zetasyanthis/quadruped/README.md

An old student project of mine!

v1 (SNUT) and v2 (ECE597) included!
