zetasyanthis/quadruped/ECE597_Robot_v2/quadruplex/trunk/doc/presentations/media/robot_v1.jpg

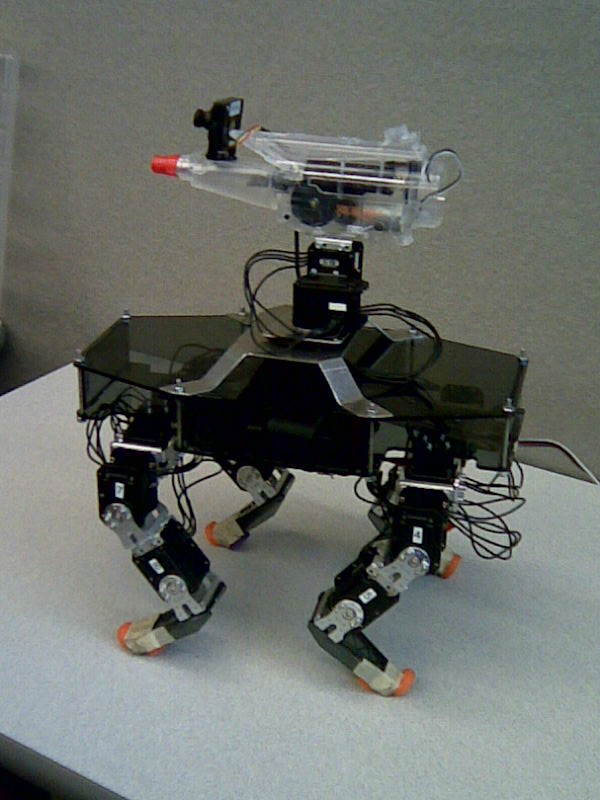
ECE597_Robot_v2/quadruplex/trunk/doc/presentations/media/robot_v1.jpg
