zetasyanthis/quadruped/ECE597_Robot_v2/quadruplex/trunk/doc/presentations/media/tasks.png

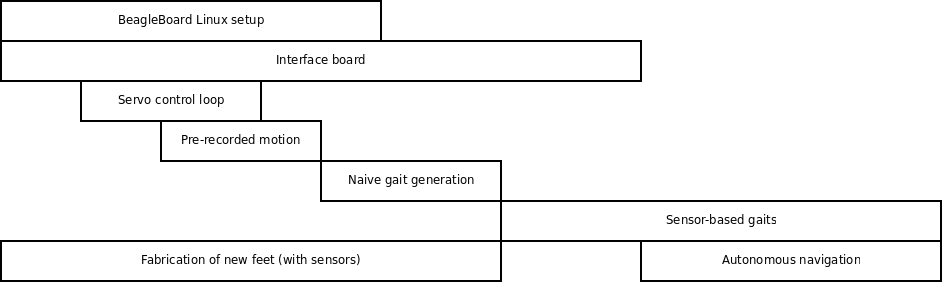
ECE597_Robot_v2/quadruplex/trunk/doc/presentations/media/tasks.png
