zetasyanthis/quadruped/ECE597_Robot_v2/quadruplex/trunk/doc/report/figures/cimg7274-board-unpopulated.jpg

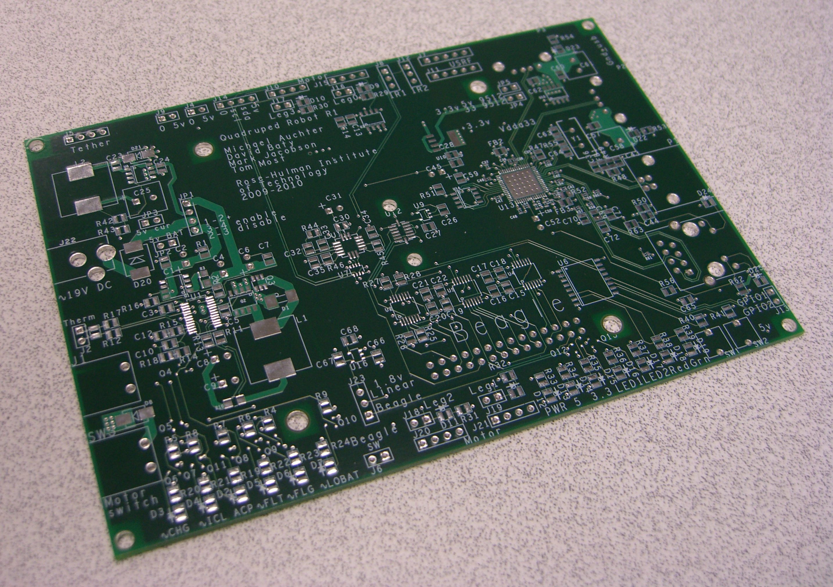
ECE597_Robot_v2/quadruplex/trunk/doc/report/figures/cimg7274-board-unpopulated.jpg
