zetasyanthis/quadruped/ECE597_Robot_v2/quadruplex/trunk/doc/software/figures/leg.jpg

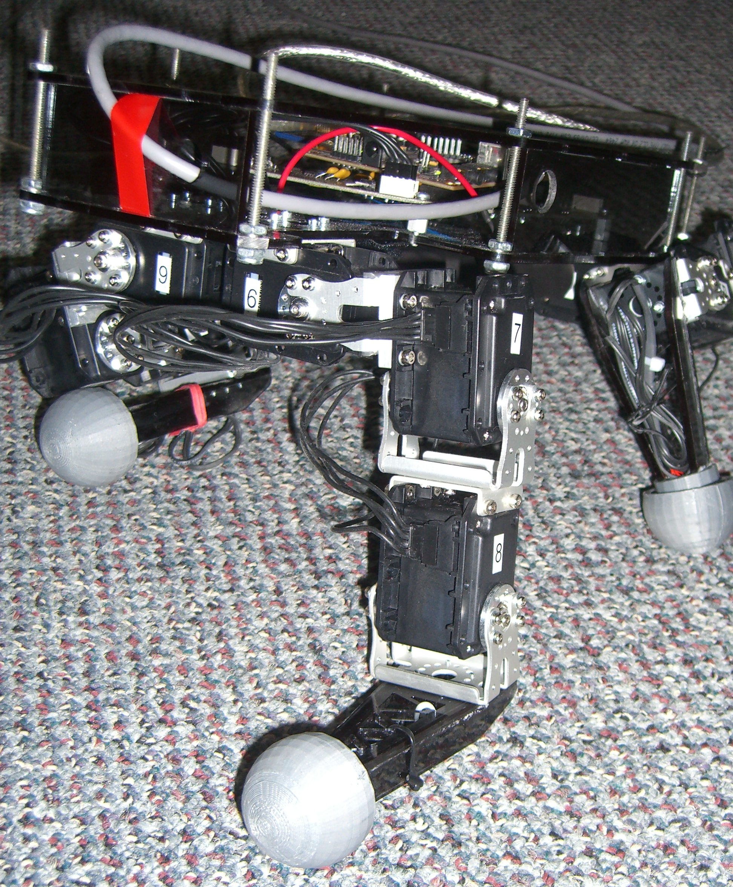
ECE597_Robot_v2/quadruplex/trunk/doc/software/figures/leg.jpg
