zetasyanthis/quadruped/ECE597_Robot_v2/quadruplex/trunk/pcb/BOM.xls

Quantity | Reference | Footprint | Value | Description | DigiKey | Mouser | Manufacturer | Man. Part Num | Min Quant | Unit Price | Total
29 | C1,C3,C13,C15,C17,C19,C21,C30,C29,C37,C38,C39,C40,C41,C42,C43,C44,C46,C47,C48,C49,C50,C51,C53,C54,C55,C57,C59,C60 | 0805 | 0.1uF | CAP CERM .10UF 50V 20% 0805 SMD | 478-3351-1-ND |  | AVX Corporation | 08055C104MAT2A | 10 | $0.05 | $1.33
2 | C11, C33 | 0805 | 0.47uF | CAP CERAMIC .47UF 25V X7R 0805 | 311-1364-1-ND |  | Yageo | CC0805KKX7R8BB474 | 10 | $0.09 | $0.91
1 | C12 | 0805 | 0.12uF | CAP .12UF 16V CERAMIC X7R 0805 | PCC1813CT-ND |  | Panasonic ECG | ECJ-2VB1C124K | 1 | $0.55 | $0.55
16 | C14,C16,C18,C20,C22,C24,C26,C27,C34,C35,C28,C36,C56,C62,C66,C67 | 0805 | 1uF | CAP CER 1.0UF 50V Y5V 0805 | 587-1308-1-ND |  | Taiyo Yuden | UMK212F105ZG-T | 10 | $0.09 | $1.41
6 | C2,C4,C6,C8,C9,C31 |  | 10uF | CAP ELECT 10UF 35V KS RADIAL | P980-ND |  | Panasonic ECG | ECE-A1VKS100 | 1 | $0.08 | $0.50
3 | C23,C32,C68 | 0805 | 0.01uF | CAP 10000PF 50V CERAMIC X7R 0805 | 399-1158-1-ND |  | Kemet | C0805C103K5RACTU | 10 | $0.03 | $0.31
1 | C25 |  | 470uF | CAP 470UF 16V ALUM LYTIC RADIAL | P5141-ND |  | Panasonic ECG | ECA-1CM471 | 1 | $0.26 | $0.26
2 | C45,C52 |  | 4.7uF | CAP 4.7UF 50V ELECT EB RADIAL | P13465-ND |  | Panasonic ECG | EEU-EB1H4R7S | 1 | $0.11 | $0.22
1 | C5 | 0805 | 15nF | CAP 15000PF 50V CERAMIC X7R 0805 | 399-1161-1-ND |  | Kemet | C0805C153K5RACTU | 10 | $0.05 | $0.46
2 | C58,C61 |  | 150uF | CAP 150UF 35V ELECT FM RADIAL | P12408-ND |  | Panasonic ECG | EEU-FM1V151 | 1 | $0.32 | $0.64
2 | C63,C64 | 0805 | 33pF | CAP CERAMIC 33PF 50V NP0 0805 | 399-1115-1-ND |  | Kemet | C0805C330J5GACTU | 10 | $0.05 | $0.48
1 | C65 | 0805 | 0.022uF | CAP 22000PF 50V CERAMIC X7R 0805 | 399-1163-1-ND |  | Kemet | C0805C223K5RACTU | 10 | $0.06 | $0.58
2 | C7,C10 | 0805 | 0.0047uF | CAP 4700PF 50V CERAMIC X7R 0805 | 399-1155-1-ND |  | Kemet | C0805C472K5RACTU | 10 | $0.04 | $0.43
1 | D1 |  |  | DIODE SCHOTTKY 40V 1A SMB | MBRS140T3GOSCT-ND |  | ON Semiconductor | MBRS140T3G | 1 | $0.41 | $0.41
6 | D2,D22,D23,D17,D19,D25 | 0805p | Green | LED GREEN CLEAR 0805 SMD | 160-1179-1-ND |  | Lite-On Inc | LTST-C170GKT | 1 | $0.09 | $0.54
1 | D20 |  | Reverse | DIODE SCHOTTKY 4A 30V SMC | SL43-E3/57TGICT-ND |  | Vishay | SL43-E3/57T | 1 | $1.07 | $1.07
1 | D21 |  |  | DIODE SCHOTTKY 40V 2A SMA | B240A-FDICT-ND |  | Diodes Inc | B240A-13-F | 1 | $0.42 | $0.42
4 | D3,D4,D7,D24 | 0805p | Amber | LED AMBER CLEAR 0805 SMD | 160-1177-1-ND |  | Lite-On Inc | LTST-C170AKT | 1 | $0.11 | $0.44
11 | D5,D6,D9,D10,D11,D12,D13,D14,D15,D16,D18 | 0805p | Red | LED RED CLEAR 0805 SMD | 160-1176-1-ND |  | Lite-On Inc | LTST-C170CKT | 1 | $0.09 | $1.02
1 | D8 |  |  | DIODE SCHOTTKY 60V 3A SMA | B360A-FDICT-ND |  | Diodes Inc | B360A-13-F | 1 | $0.56 | $0.56
1 | External |  |  | THERMISTOR 10K OHM 30MM L NTC | 490-4653-ND |  | Murata Electronics | NTSD1XH103FPB30 | 1 | $0.56 | $0.56
1 | External |  |  | CONN 2.1MM FEMALE PLUG 5.5MM OUT | CP3-1000-ND |  | CUI Inc | PP3-002A | 1 | $0.93 | $0.93
20 | External |  |  | CONN TERM FEMALE 22-30AWG TIN | WM1114-ND |  | Molex | 08-50-0114 | 100 | $0.04 | $3.90
3 | FB1,FB2,FB3 |  |  | FERRITE BEAD 120 OHM 0805 | 587-1747-1-ND |  | Taiyo Yuden | FBMH2012HM121-T | 10 | $0.09 | $0.94
2 | J1,SW3 |  | Battery | CONN HEADER RT ANG 2POS 5.08MM | 277-1106-ND |  | Phoenix Contacts | 1757242 | 1 | $0.46 | $0.92
4 | J11,J13,External |  | USRF | CONN HEADER 5POS .100 VERT TIN | WM4203-ND |  | Molex Inc | 22-23-2051 | 1 | $0.79 | $3.16
1 | J22 |  |  | CONN POWER JACK 2.1MM PCB | CP-202A-ND |  | CUI Inc | PJ-202A | 1 | $0.38 | $0.38
1 | J3 |  | Beagle | CONN HEADER FMAL 28PS .1" DL TIN | S7082-ND |  | Sullins Connector Solutions | PPTC142LFBN-RC | 1 | $1.56 | $1.56
1 | J4,J9,J13,J14,J6 |  |  | CONN HEADER 36POS .100 R/A TIN | WM6036-ND |  | Molex | 22-28-8360 | 1 | $1.81 | $1.81
5 | J5,J10,J15,J20,J21 |  | Motor | CONN HEADER 4POS 2.5MM VERT TIN | WM18888-ND |  | Molex | 22-03-5045 | 1 | $1.05 | $5.25
2 | J8,J12 |  | IR | CONN HEADER 3POS .100 VERT TIN | WM4201-ND |  | Molex |  | 1 | $0.73 | $1.46
2 | JP1,JP2,JP4,JP5,JP3,J16,J17,J18,J19,J2 |  | Jumper | BERGSTIK II .100" SR STRAIGHT | 609-3505-ND |  | FCI | 68000-436HLF | 1 | $0.96 | $1.92
1 | L1 |  | 10uH | INDUCTOR SHIELD PWR 10UH SMD | 513-1525-1-ND |  | Coiltronics | DR125-100-R | 1 | $1.74 | $1.74
1 | L2 |  | 39uH | INDUCTOR 39UH 3.5A SHIELD SMD | 308-1338-1-ND |  | Sumida America Components | CDRH127/LDNP-390MC | 1 | $2.02 | $2.02
1 | P1 |  |  | CONN USB JACK TYPE B HORIZON R/A | 151-1121-ND |  | EDAC Inc | 690-004-221-023 | 1 | $0.93 | $0.93
2 | P2,P3 |  |  | CONN RCPT USB TYPE A R/A PCB | 609-1045-ND |  | FCI | 87520-0010BLF | 1 | $0.95 | $1.90
1 | Q1 |  |  | MOSFET P-CH DUAL 30V 5.3A 8-SOIC | SI4925BDY-T1-E3CT-ND |  | Vishay | SI4925BDY-T1-E3 | 1 | $2.31 | $2.31
1 | Q2 |  |  | MOSFET P-CH 30V 5.7A 8-SOIC | SI4431BDY-T1-E3CT-ND |  | Vishay | SI4431BDY-T1-E3 | 1 | $1.38 | $1.38
1 | Q3 |  |  | MOSFETs SSOT-6 N-CH |  | 512-FDC645N | Fairchild Semiconductor | FDC645N | 1 | $0.89 | $0.89
5 | Q4,Q5,Q11,Q12,Q13 |  |  | MOSFET N-CH 60V 115MA SOT23-3 | 2N7002CT-ND |  | Diodes/Zetex | 2N7002TA | 1 | $0.26 | $1.30
5 | Q6,Q7,Q8,Q9,Q10 |  |  | MOSFETs -60V 100hm |  | 689-TP0610T-G | Supertex | TP0610T-G | 1 | $0.49 | $2.45
7 | R1,R16,R40,R41,R42,R44,R51 | 0805 | 10k | RES 10K OHM 1/8W 5% 0805 SMD | RHM10KARCT-ND |  | Rohm Semiconductor | MCR10EZPJ103 | 10 | $0.03 | $0.34
1 | R10 | 1206Kelvin | 0.025 | RES .025 OHM 1/2W 1% 1206 SMD | CSR1/20.025FICT-ND |  | Stackpole Electronics Inc | CSR 1/2 0.025 1% I | 1 | $0.68 | $0.68
2 | R11,R13 | 0805 | 3.01k | RES 3.01K OHM 1/8W 1% 0805 SMD | RHM3.01KCRCT-ND |  | Rohm Semiconductor | MCR10EZPF3011 | 10 | $0.04 | $0.38
1 | R12 | 0805 | 32.4k | RES 32.4K OHM 1/8W 1% 0805 SMD | RHM32.4KCRCT-ND |  | Rohm Semiconductor | MCR10EZPF3242 | 10 | $0.04 | $0.38
1 | R14 | 0805 | 26.7k | RES 26.7K OHM 1/8W 1% 0805 SMD | RHM26.7KCRCT-ND |  | Rohm Semiconductor | MCR10EZPF2672 | 10 | $0.04 | $0.38
1 | R15 | 0805 | 6.04k | RES 6.04K OHM 1/8W 1% 0805 SMD | RHM6.04KCRCT-ND |  | Rohm Semiconductor | MCR10EZPF6041 | 10 | $0.04 | $0.38
1 | R17 | 0805 | 309k | RES 309K OHM 1/8W 1% 0805 SMD | RHM309KCRCT-ND |  | Rohm Semiconductor | MCR10EZPF3093 | 10 | $0.04 | $0.38
1 | R18 | 0805 | 52.3k | RES 52.3K OHM 1/8W 1% 0805 SMD | RHM52.3KCRCT-ND |  | Rohm Semiconductor | MCR10EZPF5232 | 10 | $0.04 | $0.38
15 | R19,R20,R21,R22,R23,R24,R29,R30,R31,R32,R34,R36,R37,R38,R39 | 0805 | 300 | RES 300 OHM 1/8W 5% 0805 SMD | RHM300ARCT-ND |  | Rohm Semiconductor | MCR10EZPJ301 | 10 | $0.03 | $0.51
2 | R2,R62 | 0805 | 0 | RES 0.0 OHM 1/8W 5% 0805 SMD | RHM0.0ARCT-ND |  | Rohm Semiconductor | MCR10EZPJ000 | 10 | $0.03 | $0.34
4 | R25,R26,R27,R28 | 0805 | 3.3k | RES 3.3K OHM 1/8W 5% 0805 SMD | RHM3.3KARCT-ND |  | Rohm Semiconductor | MCR10EZPJ332 | 10 | $0.03 | $0.34
1 | R3 | 1206Kelvin | 0.033 | Current Sensing Resistors 1/2W .033 1% 100ppm |  | 66-LR1206-LF-R033-F | IRC | LR1206-LF-R033-F | 1 | $0.54 | $0.54
1 | R33 | 0805 | 1.5k | RES 1.5K OHM 1/8W 5% 0805 SMD | RHM1.5KARCT-ND |  | Rohm Semiconductor | MCR10EZPJ152 | 10 | $0.03 | $0.34
1 | R35 | 0805 | 130 | RES 130 OHM 1/8W 5% 0805 SMD | RHM130ARCT-ND |  | Rohm Semiconductor | MCR10EZPJ131 | 10 | $0.03 | $0.34
6 | R4,R5,R6,R7,R8,R9 | 0805 | 100k | RES 100K OHM 1/8W 5% 0805 SMD | RHM100KARCT-ND |  | Rohm Semiconductor | MCR10EZPJ104 | 10 | $0.03 | $0.34
1 | R43 | 0805 | 3.16k | RES 3.16K OHM 1/8W 1% 0805 SMD | RHM3.16KCRCT-ND |  | Rohm Semiconductor | MCR10EZPF3161 | 10 | $0.03 | $0.34
2 | R45,R46 | 0805 | 33k | RES 33K OHM 1/8W 5% 0805 SMD | RHM33KARCT-ND |  | Rohm Semiconductor | MCR10EZPJ333 | 10 | $0.03 | $0.34
1 | R47 | 0805 | 12.0K | RES 12.0K OHM 1/8W 1% 0805 SMD | RHM12.0KCRCT-ND |  | Rohm Semiconductor | MCR10EZPF1202 | 10 | $0.03 | $0.34
1 | R48 | 0805 | 39.2K | RES 39.2K OHM 1/8W 1% 0805 SMD | RHM39.2KCRCT-ND |  | Rohm Semiconductor | MCR10EZPF3922 | 10 | $0.03 | $0.34
1 | R49 | 0805 | 61.9K | RES 61.9K OHM 1/8W 1% 0805 SMD | RHM61.9KCRCT-ND |  | Rohm Semiconductor | MCR10EZPF6192 | 10 | $0.04 | $0.38
3 | R50,R56,R63 | 0805 | 332 | RES 332 OHM 1/8W 1% 0805 SMD | RHM332CRCT-ND |  | Rohm Semiconductor | MCR10EZPF3320 | 10 | $0.04 | $0.38
1 | R52 | 0805 | 12.4K | RES 12.4K OHM 1/8W 1% 0805 SMD | RHM12.4KCRCT-ND |  | Rohm Semiconductor | MCR10EZPF1242 | 10 | $0.04 | $0.38
2 | R53,R54 | 0805 | 511 | RES 511 OHM 1/8W 1% 0805 SMD | RHM511CRCT-ND |  | Rohm Semiconductor | MCR10EZPF5110 | 10 | $0.04 | $0.38
1 | R55 | 0805 | 1.00M | RES 1.0M OHM 1/8W 5% 0805 SMD | RHM1.0MARCT-ND |  | Rohm Semiconductor | MCR10EZPJ105 | 10 | $0.03 | $0.34
4 | R57,R58,R59,R60 | 0603 | 49.9 |  |  |  |  |  | 10 | $0.00 | $0.00
1 | R61 | 0603 | 10 |  |  |  |  |  | 10 | $0.00 | $0.00
2 | SW1,SW2 |  | Switch | N/A |  |  |  |  |  |  | $0.00
1 | T1 |  |  | CONN PULSEJACK 1PORT 10/100B-TX | 553-1483-ND |  | Pulse | J0011D01BNL | 1 | $6.87 | $6.87
1 | U1 |  |  | IC BATT CHARGER CTRLR 4A 24SSOP | LTC4007EGN#PBF-ND |  | Linear Technology | LTC4007EGN#PBF | 1 | $7.63 | $7.63
1 | U10 |  |  | IC REG LDO 500MA 3.3V SOT223 | LP38693MP-3.3CT-ND |  | National Semiconductor | LP38693MP-3.3/NOPB | 1 | $1.79 | $1.79
1 | U11 |  |  | GYROSCOPE MEMS DUAL AXIS 16-LGA | 497-8967-1-ND |  | STMicroelectronics | LPR510ALTR | 1 | $8.90 | $8.90
1 | U12 |  |  | IC ACCEL SPI/I2C 3AX 14LGA | ADXL345BCCZ-RL7CT-ND |  | Analog Devices Inc | ADXL345BCCZ-RL7 | 1 | $6.16 | $6.16
1 | U13 |  |  | Ethernet ICs USB 2 Port Hub Int 10/100 Ethernet |  | 886-LAN9512-JZX | SMSC | LAN9512-JZX | 1 | $6.08 | $6.08
1 | U14 |  |  | IC EEPROM 4KBIT 2MHZ 8SOIC | 93LC66A-I/SN-ND |  | Microchip Technology | 93LC66A-I/SN | 1 | $0.36 | $0.36
1 | U15 |  |  | IC PWR SWITCH USB HISIDE 8-SOIC | AP1212HSLDICT-ND |  | Diodes Inc | AP1212HSL-13 | 1 | $2.35 | $2.35
1 | U16 |  |  | IC 1.8V 100MA LDO REG SOT-23-5 | 296-11865-1-ND |  | Texas Instruments | TPS79118DBVR | 1 | $1.52 | $1.52
3 | U2,U4,U5 |  |  | IC LVL XLTR LV 8MBPS 14-TSSOP | MAX3378EEUD+-ND |  | Maxim Integrated Products | MAX3378EEUD+ | 1 | $2.94 | $8.82
1 | U3 |  |  | IC RS-485 TXRX HIGH OUT 8-SOIC | 296-12990-5-ND |  | Texas Instruments | SN65HVD07D | 1 | $4.17 | $4.17
1 | U6 |  |  | IC I/O EXPANDER I2C 8B 16SOIC | 568-4235-5-ND |  | NXP Semiconductors | PCA8574AD,512 | 1 | $1.64 | $1.64
1 | U7 |  |  | IC ADC 12BIT 4CH SAR I2C SOT23-8 | AD7991YRJZ-1500RL7CT-ND |  | Analog Devices Inc | AD7991YRJZ-1500RL7 | 1 | $6.62 | $6.62
1 | U8A |  |  | IC STEP-DOWN CONV 2A 8-SOIC | 296-19671-5-ND |  | Texas Instruments | TPS5420D | 1 | $5.32 | $5.32
1 | U9 |  |  | IC LDO REG 150MA 2.3V TSOT23-5 | 296-24058-1-ND |  | Texas Instruments | TPS78223DDCR | 1 | $1.63 | $1.63
1 | Y1 |  | 25.00MHz | CRYSTAL 25.000 MHZ 18PF HC49US | 887-1028-ND |  | TXC Technology | 9B-25.000MAAJ-B | 1 | $0.46 | $0.46
 |  |  |  |  |  |  |  |  |  | Total | $129.85
