zetasyanthis/quadruped/ECE597_Robot_v2/quadruplex/branches/SNUT/CAD/Frame6.igs

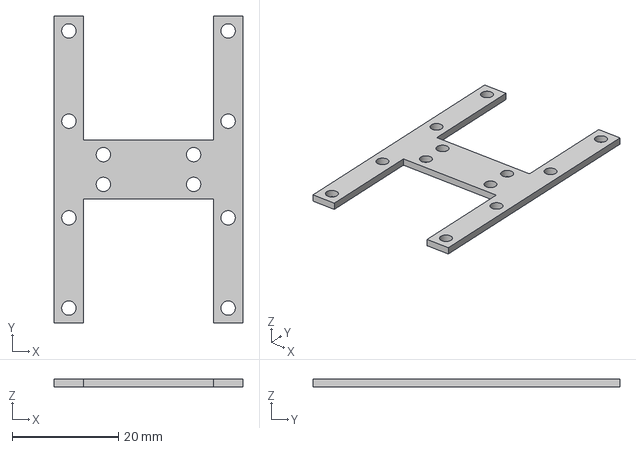
[picture p17: CAD file, 2015-01-20]
ECE597_Robot_v2/quadruplex/branches/SNUT/CAD/Frame6.igs
35.6 x 57.8 x 1.50 mm
