zetasyanthis/quadruped/ECE597_Robot_v2/quadruplex/branches/SNUT/CAD/Frame5.igs

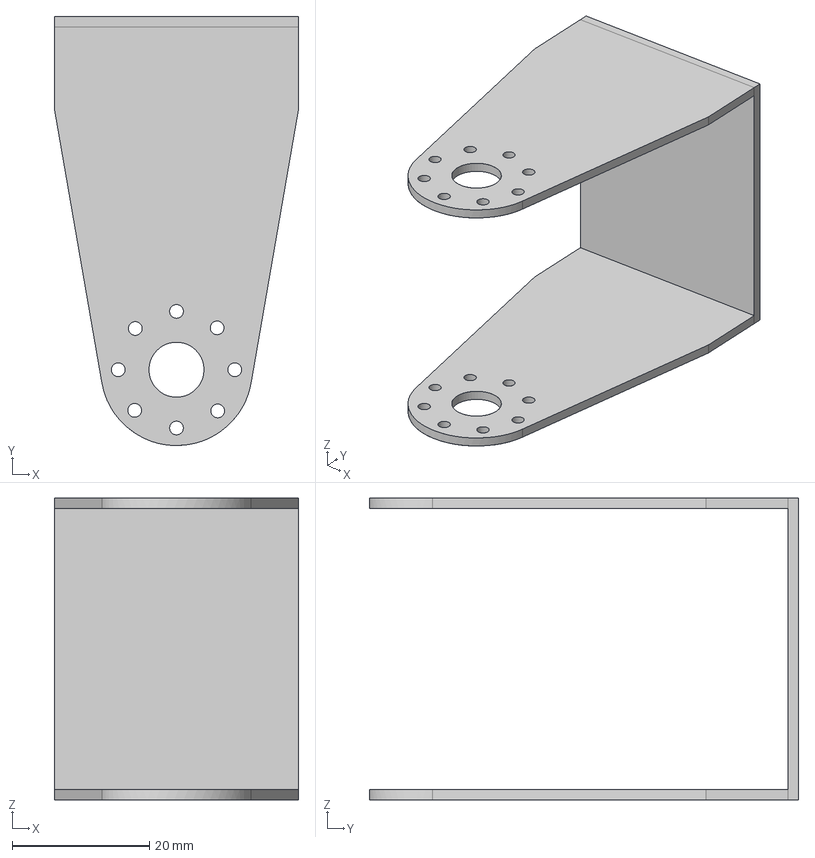
[picture p18: CAD file, 2015-01-20]
ECE597_Robot_v2/quadruplex/branches/SNUT/CAD/Frame5.igs
35.6 x 62.6 x 44.0 mm
