zetasyanthis/quadruped/ECE597_Robot_v2/quadruplex/branches/SNUT/CAD/Frame1.igs

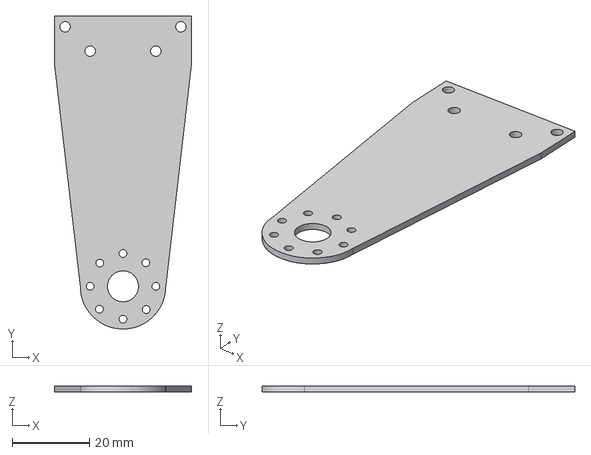
[picture p19: CAD file, 2015-01-20]
ECE597_Robot_v2/quadruplex/branches/SNUT/CAD/Frame1.igs
35.6 x 81.1 x 1.50 mm
