zetasyanthis/quadruped/ECE597_Robot_v2/quadruplex/branches/SNUT/CAD/Frame4.igs

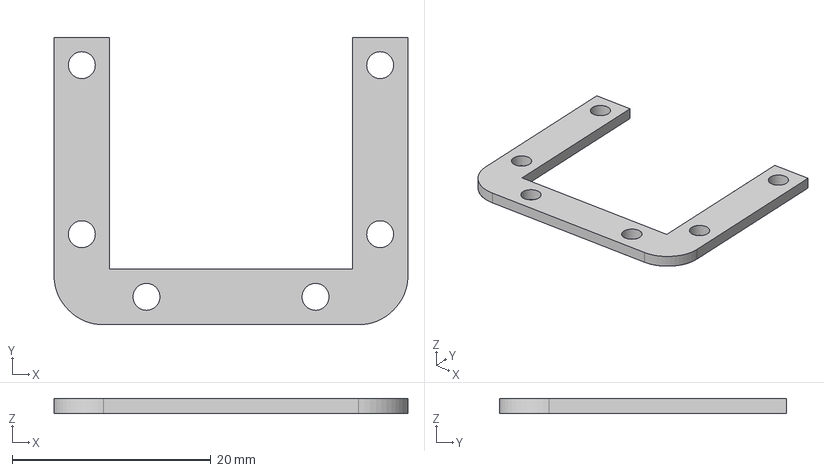
[picture p20: CAD file, 2015-01-20]
ECE597_Robot_v2/quadruplex/branches/SNUT/CAD/Frame4.igs
35.6 x 28.9 x 1.50 mm
