zetasyanthis/quadruped/ECE597_Robot_v2/quadruplex/branches/SNUT/CAD/Frame3.igs

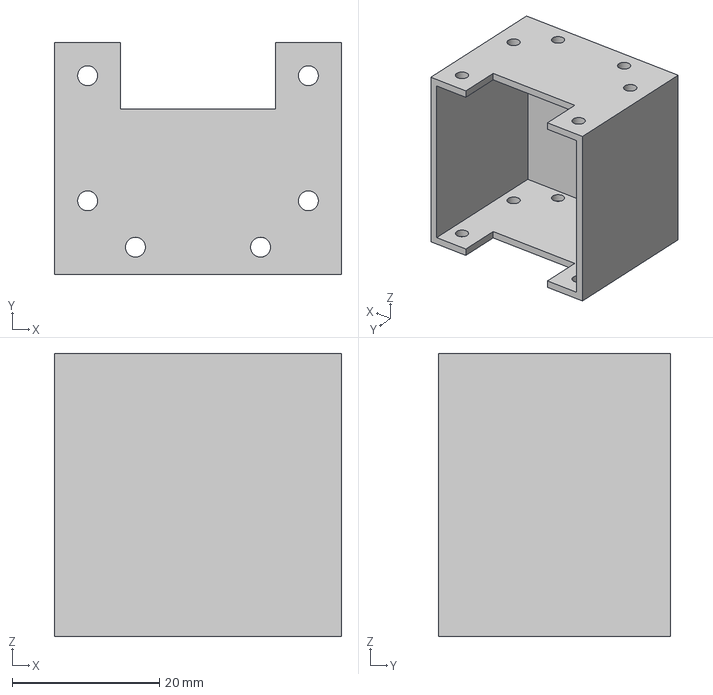
[picture p21: CAD file, 2015-01-20]
ECE597_Robot_v2/quadruplex/branches/SNUT/CAD/Frame3.igs
39.0 x 31.5 x 38.5 mm
