zetasyanthis/quadruped/ECE597_Robot_v2/quadruplex/branches/SNUT/CAD/Body_with_Frame3.igs

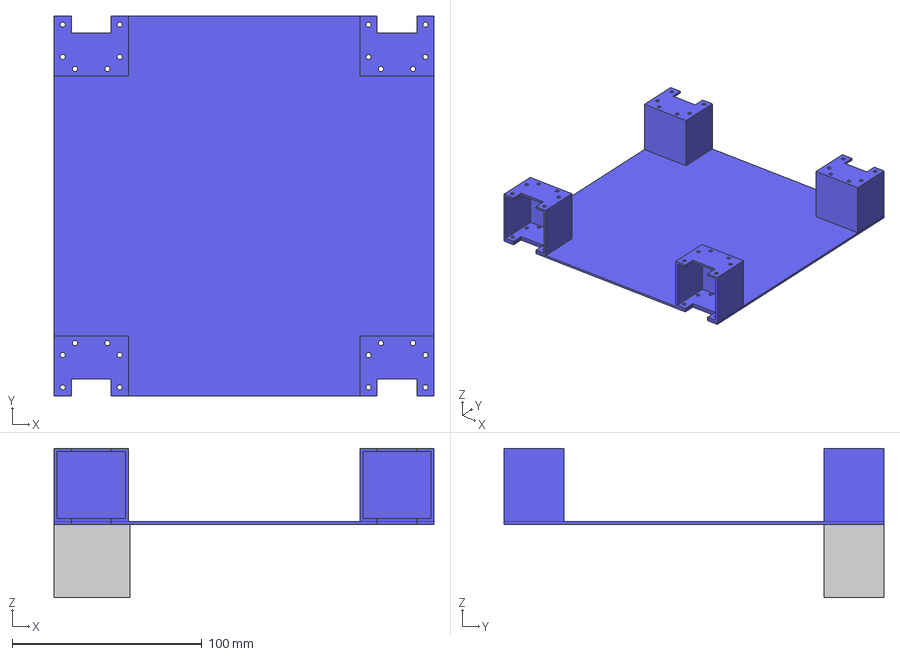
[picture p24: CAD file, 2015-01-20]
ECE597_Robot_v2/quadruplex/branches/SNUT/CAD/Body_with_Frame3.igs
200.1 x 200.0 x 78.5 mm
