zetasyanthis/quadruped/ECE597_Robot_v2/quadruplex/branches/SNUT/CAD/RX28.igs

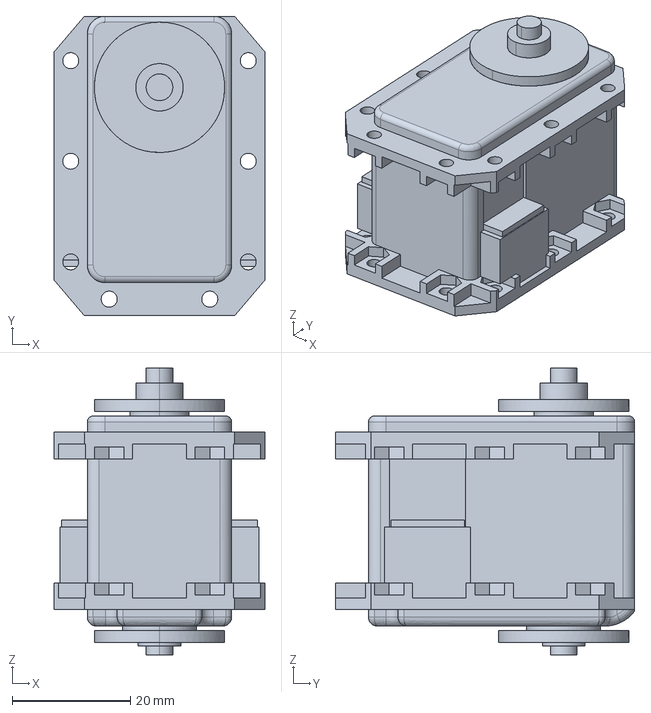
[picture p26: CAD file, 2015-01-20]
ECE597_Robot_v2/quadruplex/branches/SNUT/CAD/RX28.igs
35.6 x 50.6 x 48.5 mm
