zetasyanthis/quadruped/ECE597_Robot_v2/quadruplex/trunk/pcb/r1.pdf

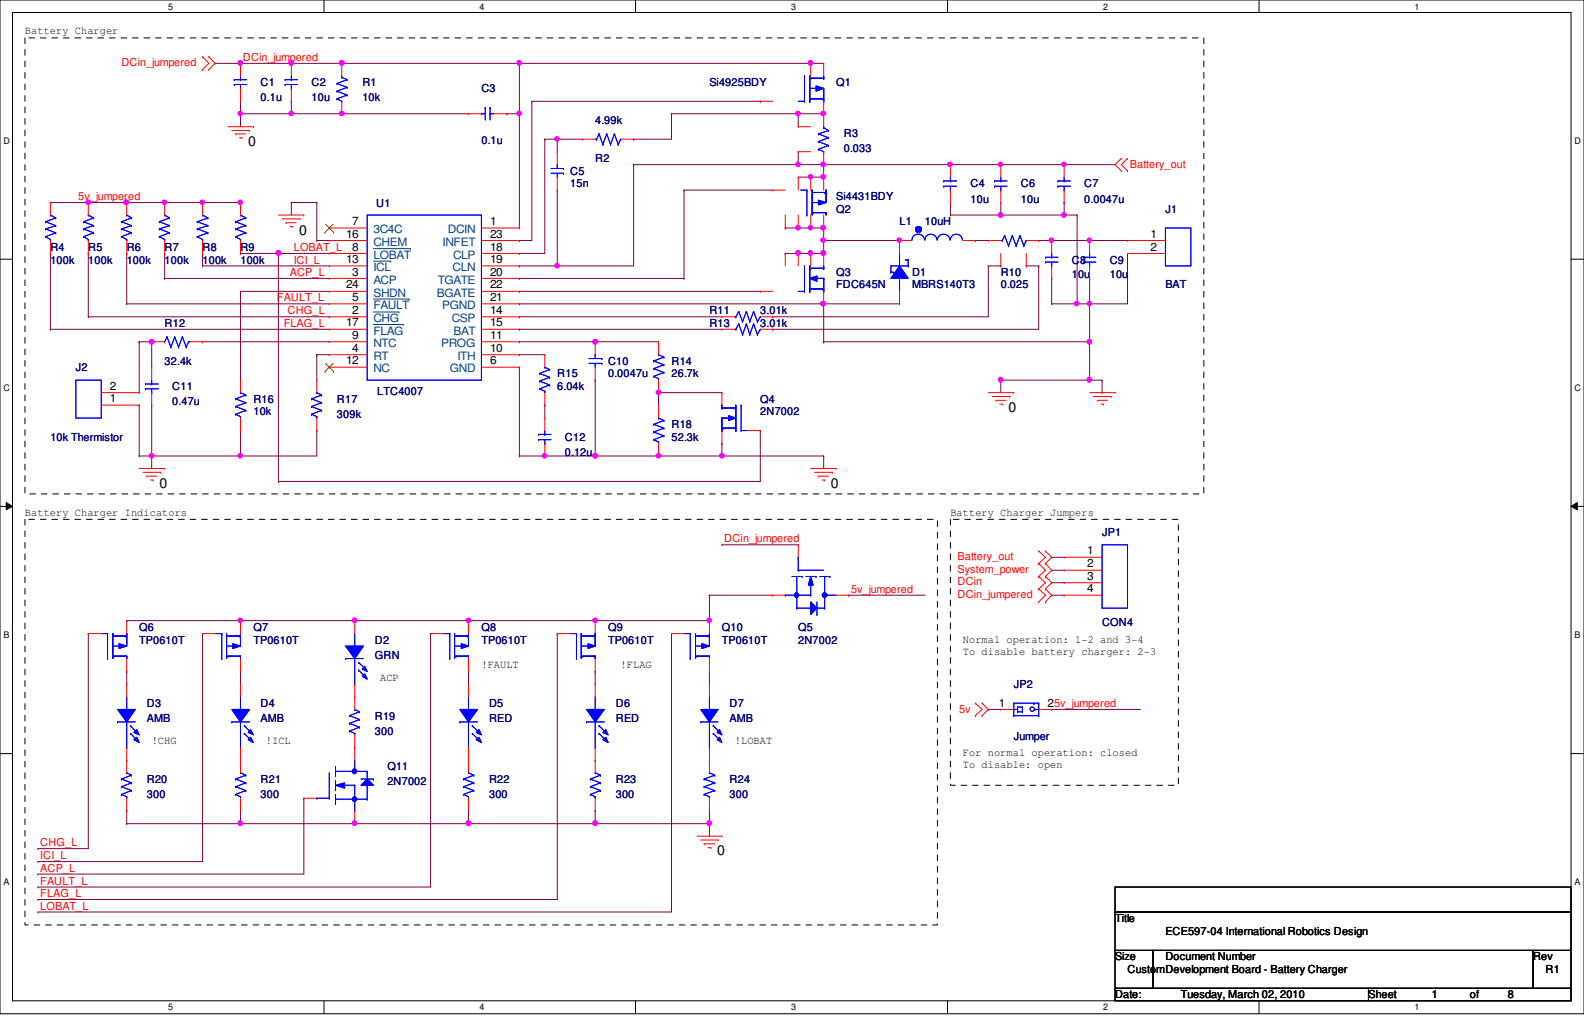
[picture p27: page 1]

Normal operation: 1-2 and 3-4
To disable battery charger: 2-3

For normal operation: closed
To disable: open

D | D
C | C
B | B
A | A

Ensure that placement is correct so pin numbers line up with beagle board (this involves "placing" it on the bottom of the board).

0 | 0

5v_beagle

I2C2_SDA | I2C2_SCL

UART2_RX

UART2_TX

1.8v_beagle

GPIO_138

GPIO_139

GPIO_137
GPIO_136 | UART2_RTS
GPIO_135
GPIO_134
GPIO_133

Accel_INT1

Accel_INT2

Title

Size | Document Number | Rev
Date: | Sheet | of
| Development Board - Beagle Board Connectors | R1

ECE597-04 International Robotics Design

A

Monday, March 01, 2010 | 2 | 8

Title

Size | Document Number | Rev
| Development Board - Beagle Board Connectors | R1

ECE597-04 International Robotics Design

A

Monday, March 01, 2010 | 2 | 8

Title

Size | Document Number | Rev
| Development Board - Beagle Board Connectors | R1

ECE597-04 International Robotics Design

A

Monday, March 01, 2010 | 2 | 8

J3

BeagleBoard_J3

VIO_1V8 1 | DC_5V | 2
MMC_DAT7 3 | UART2_CTS/McBSP3_DX/GPT9_PWMEVT | 4
MMC_DAT6 5 | UART2_TX/McBSP3_CLKX/GPT11_PWMEVT | 6
MMC_DAT5 7 | McBSP3_FSX/UART2_RX | 8
MMC_DAT4 9 | UART2_RTS/McBSP3_DR/GPT10_PWMEVT | 10
MMC2_DAT3/McBSP3_DR 11 | McBSP1_DX/McSPI4_SIMO/McBSP3_DX | 12
MMC2_DAT2/McSPI3_CS1 13 | McBSP1_CLKX/McBSP3_CLKX | 14
MMC_DAT1 15 | McBSP1_FSX/McSPI4_CS0/McBSP3_FSX | 16
MMC2_DAT0/McSPI3_SOMI 17 | McBSP1_DR/McSPI4_SOMI/McBSP3_DR | 18
MMC2_CMD/McSPI3_SIMO 19 | McBSP1_CLKR/McSPI4_CLK | 20
MMC2_CLKO 21 | McBSP1_FSR | 22
I2C2_SDA 23 | I2C2_SCL | 24
REGEN 25 | RESET | 26
GND1 27 | GND2 | 28

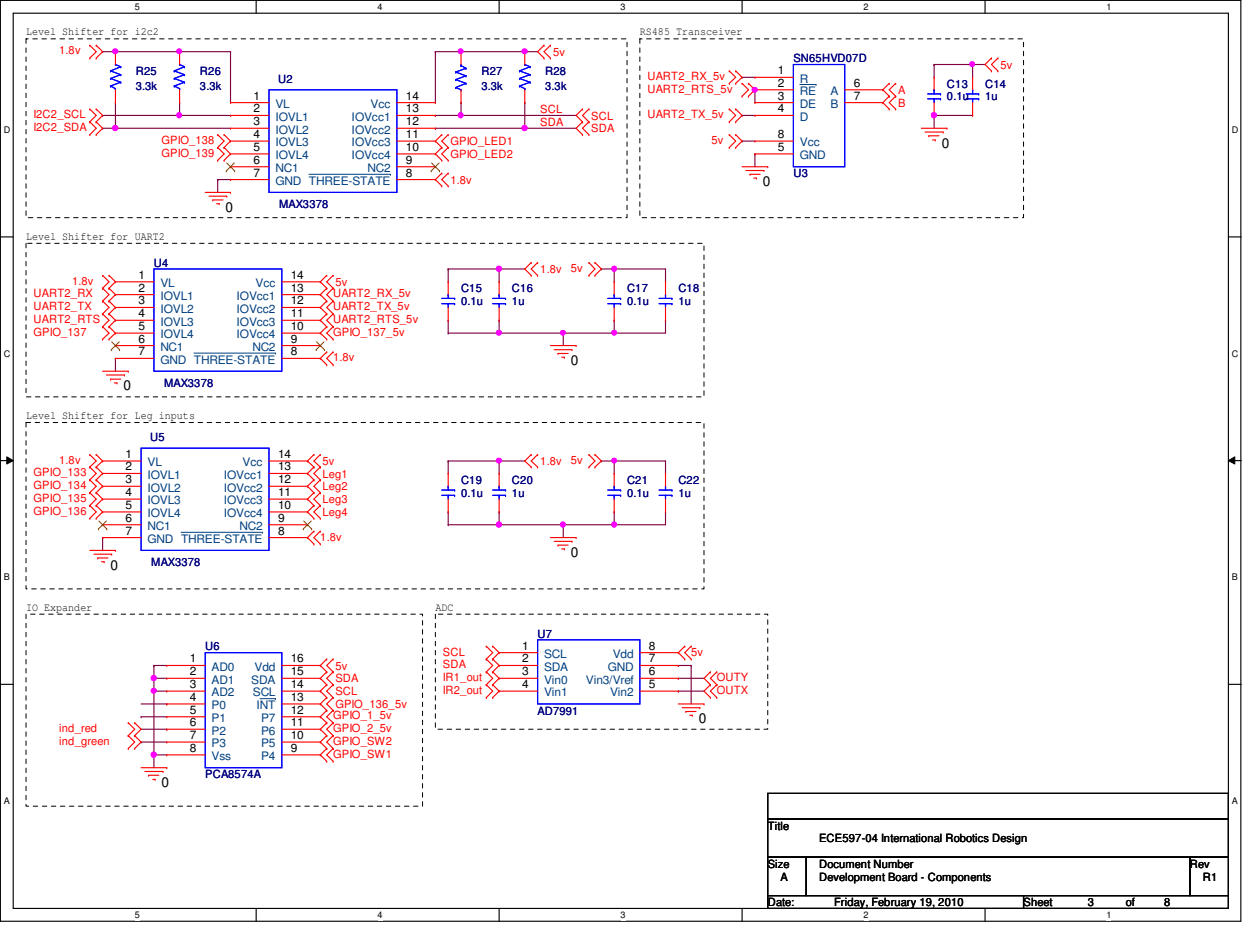
[picture p28: page 3]

Level Shifter for Leg inputs

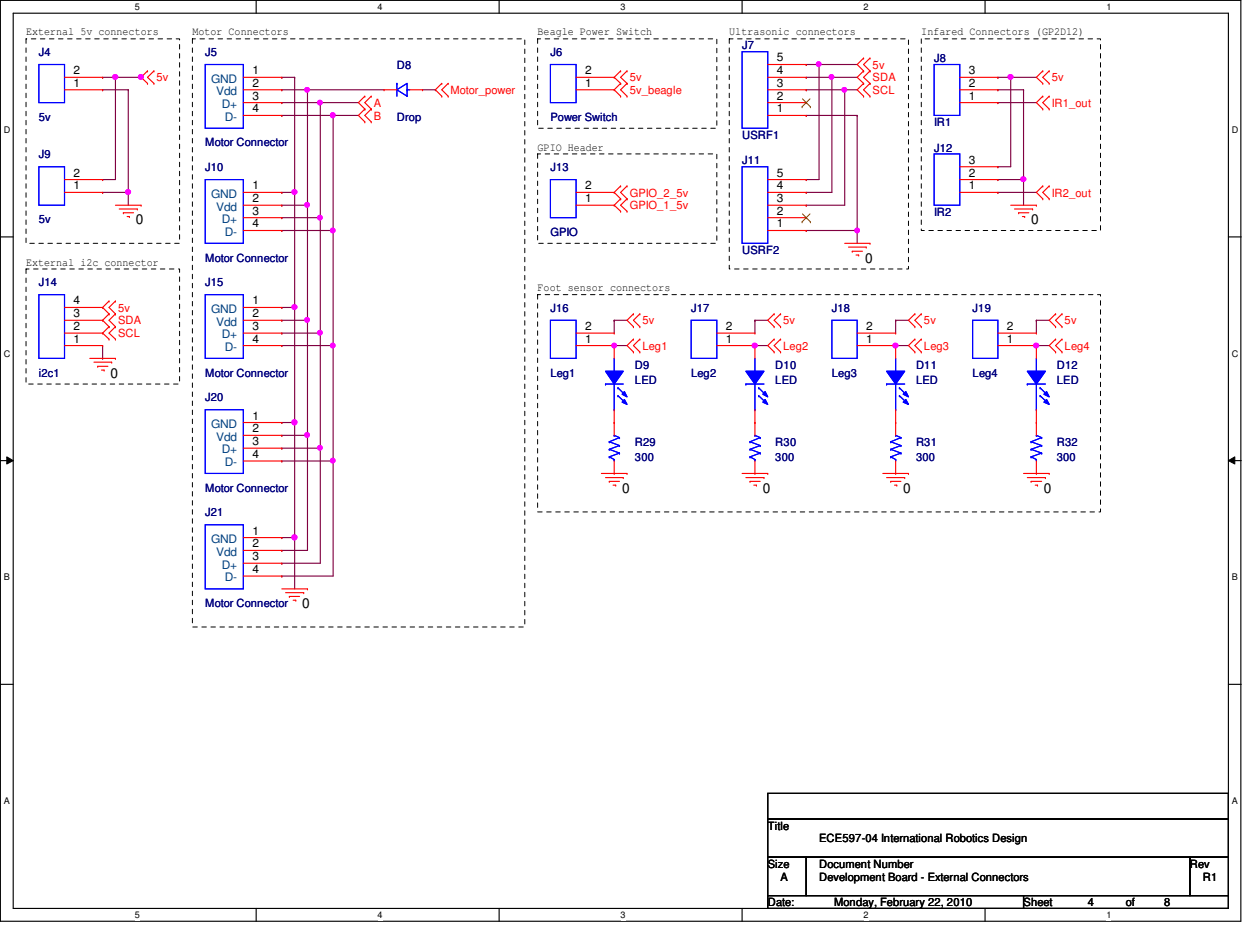
[picture p29: page 4]

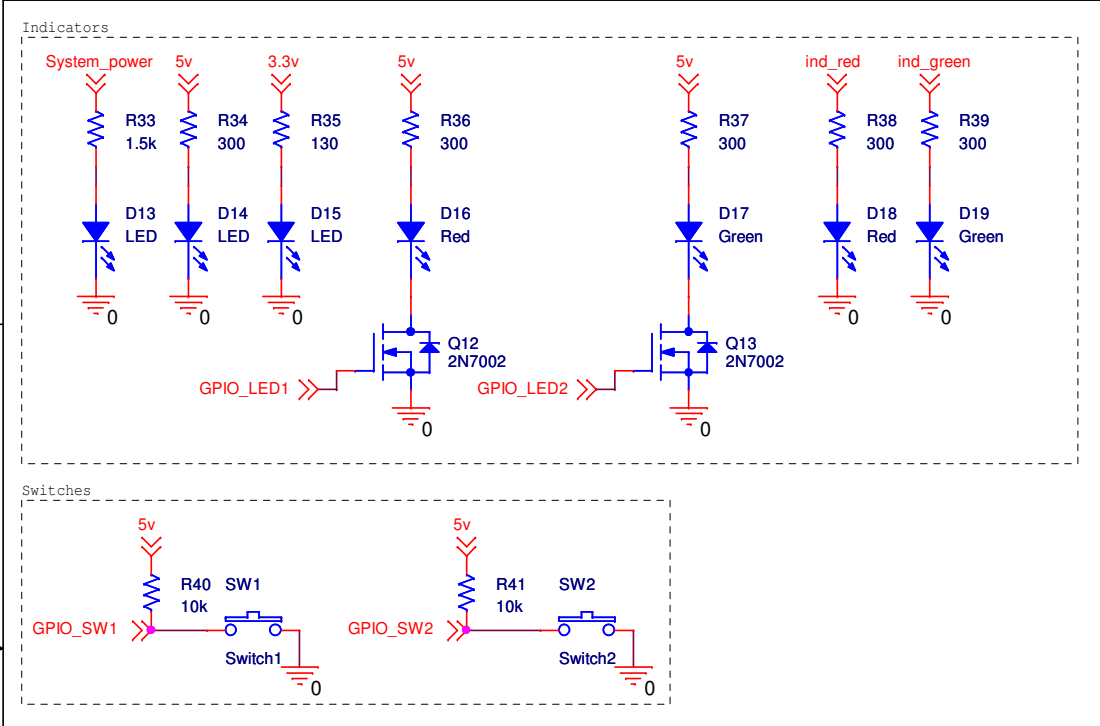
[picture p30: page 5]

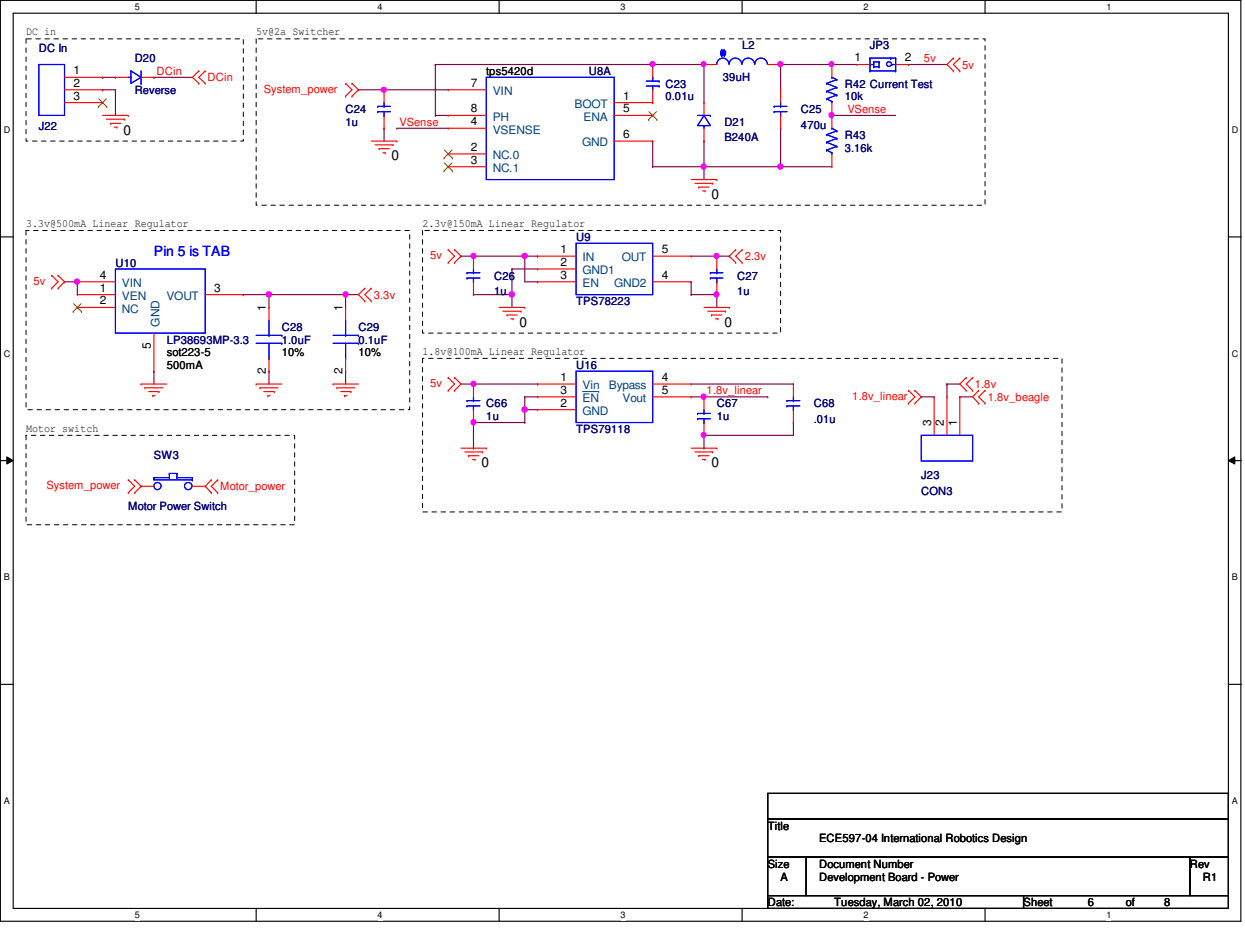
[picture p31: page 6]

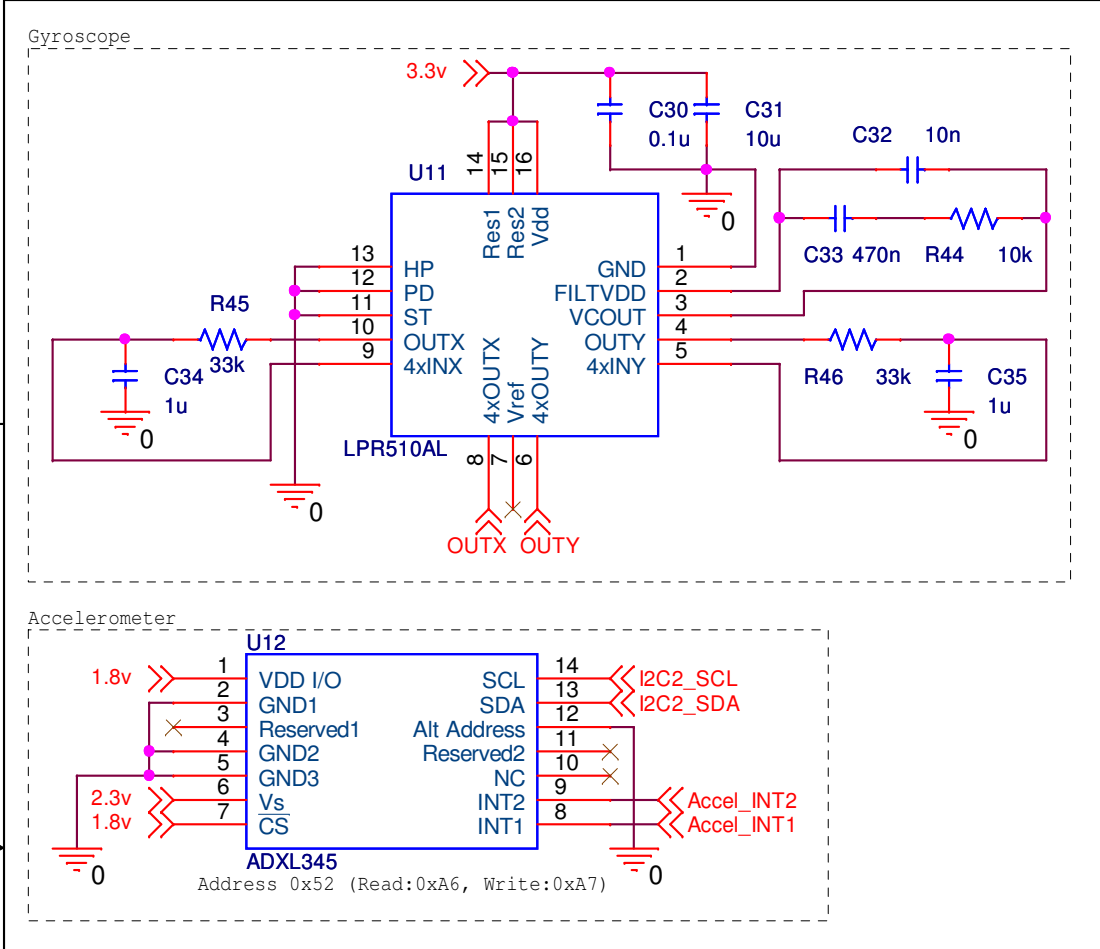
[picture p32: page 7]

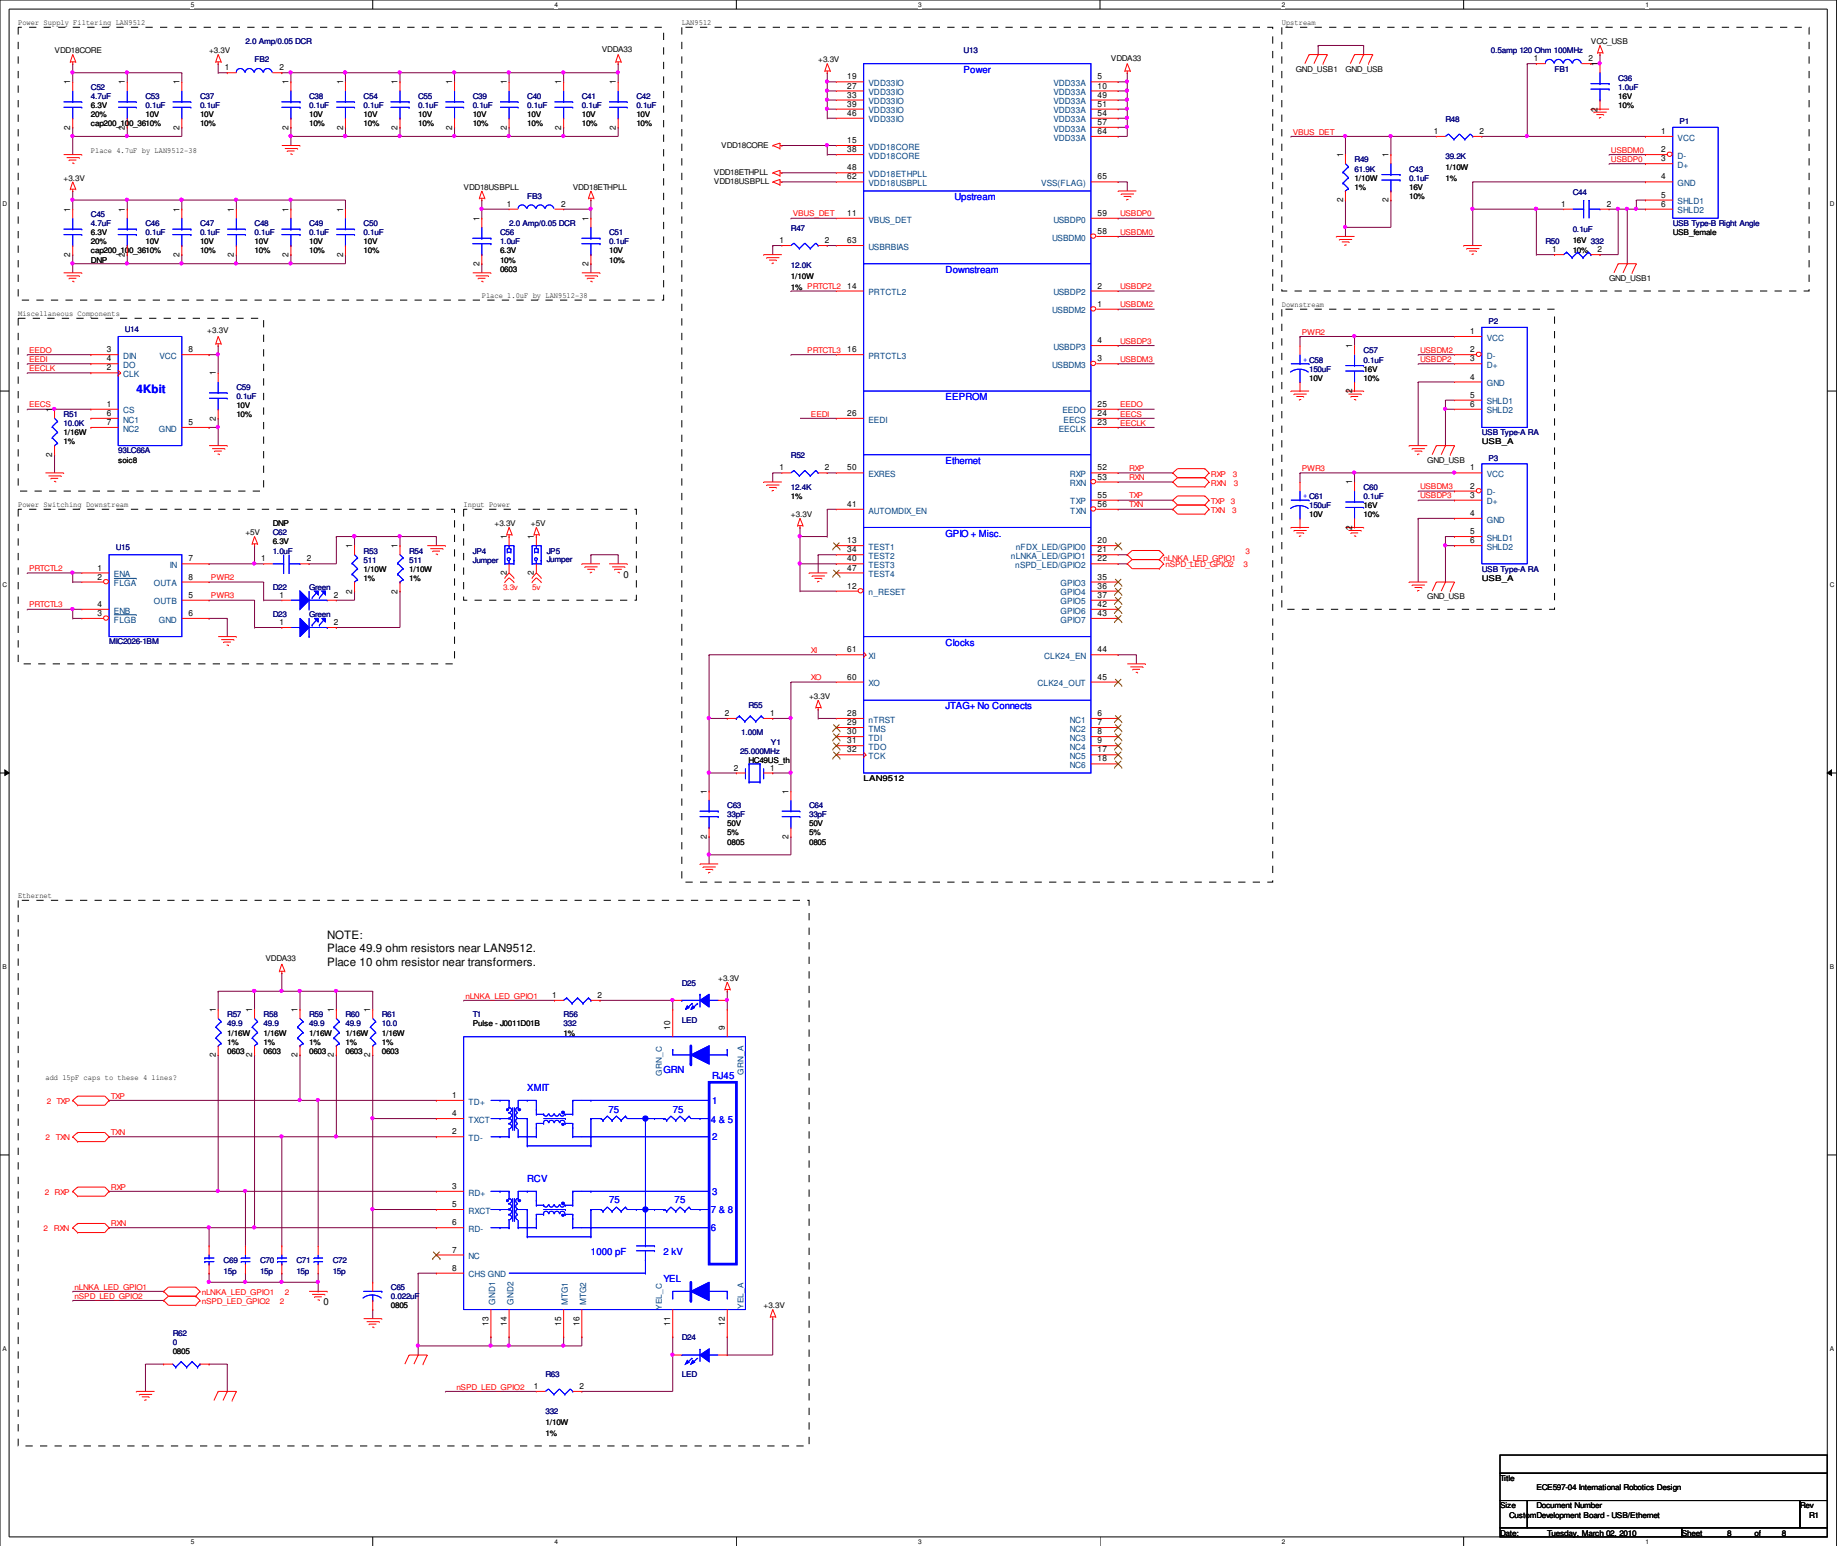
[picture p33: page 8]

USB Type-B Right Angle
USB_female

NOTE:
Place 49.9 ohm resistors near LAN9512.
Place 10 ohm resistor near transformers.

add 15pF caps to these 4 lines?
