zetasyanthis/quadruped/ECE597_Robot_v2/quadruplex/trunk/doc/pcb/r0.pdf

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
5v_switched

I2C2_SDA | I2C2_SCL

UART2_RX

UART2_TX

1.8v

GPIO_138

GPIO_139

GPIO_137
GPIO_136

Title

Size | Document Number | Rev
Date: | Sheet | of
| Development Board - Beagle Board Connectors | R0

ECE597-04 International Robotics Design

A

Monday, September 21, 2009 | 1 | 1

Title

Size | Document Number | Rev
| Development Board - Beagle Board Connectors | R0

ECE597-04 International Robotics Design

A

Title

Size | Document Number | Rev
| Development Board - Beagle Board Connectors | R0

ECE597-04 International Robotics Design

A

J3

BeagleBoard_J3

VIO_1V8 1 | DC_5V | 2
MMC_DAT7 3 | UART2_CTS/McBSP3_DX/GPT9_PWMEVT | 4
MMC_DAT6 5 | UART2_TX/McBSP3_CLKX/GPT11_PWMEVT | 6
MMC_DAT5 7 | McBSP3_FSX/UART2_RX | 8
MMC_DAT4 9 | UART2_RTS/McBSP3_DR/GPT10_PWMEVT | 10
MMC2_DAT3/McBSP3_DR 11 | McBSP1_DX/McSPI4_SIMO/McBSP3_DX | 12
MMC2_DAT2/McSPI3_CS1 13 | McBSP1_CLKX/McBSP3_CLKX | 14
MMC_DAT1 15 | McBSP1_FSX/McSPI4_CS0/McBSP3_FSX | 16
MMC2_DAT0/McSPI3_SOMI 17 | McBSP1_DR/McSPI4_SOMI/McBSP3_DR | 18
MMC2_CMD/McSPI3_SIMO 19 | McBSP1_CLKR/McSPI4_CLK | 20
MMC2_CLKO 21 | McBSP1_FSR | 22
I2C2_SDA 23 | I2C2_SCL | 24
REGEN 25 | RESET | 26
GND1 27 | GND2 | 28

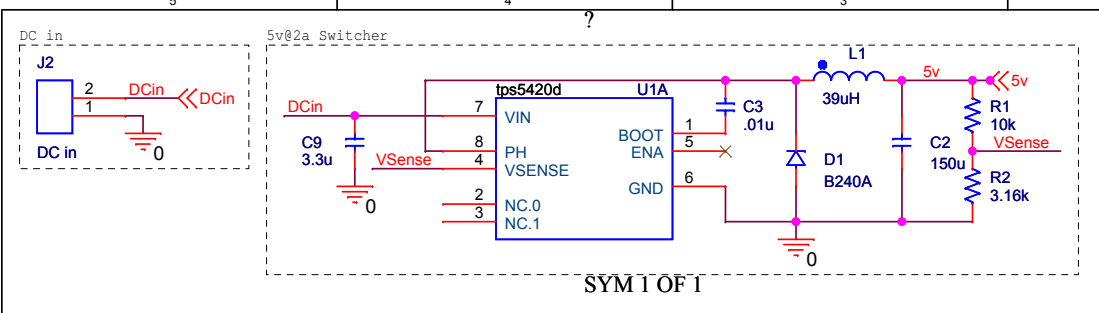
[picture p34: page 2]

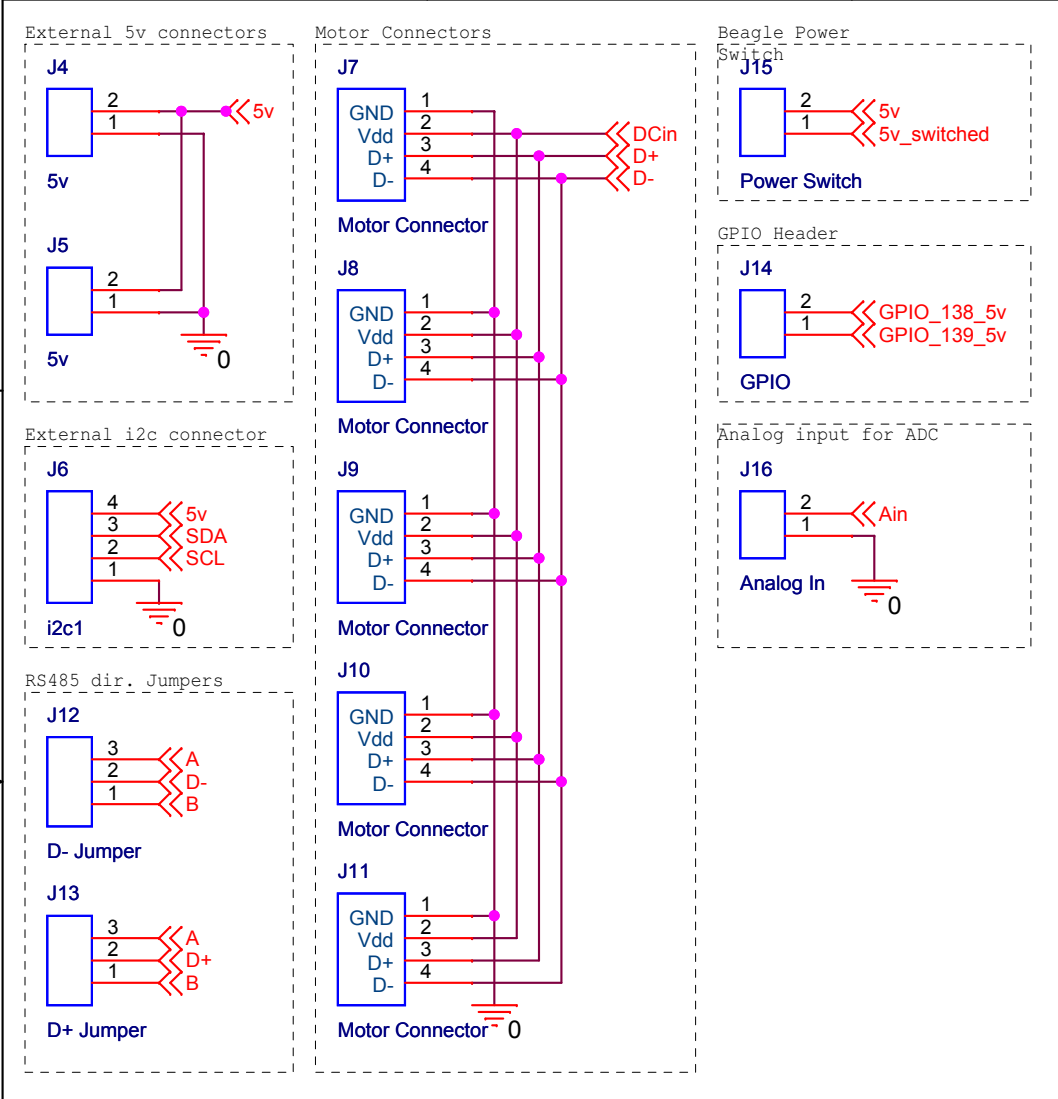
[picture p35: page 3]

Analog input for ADC

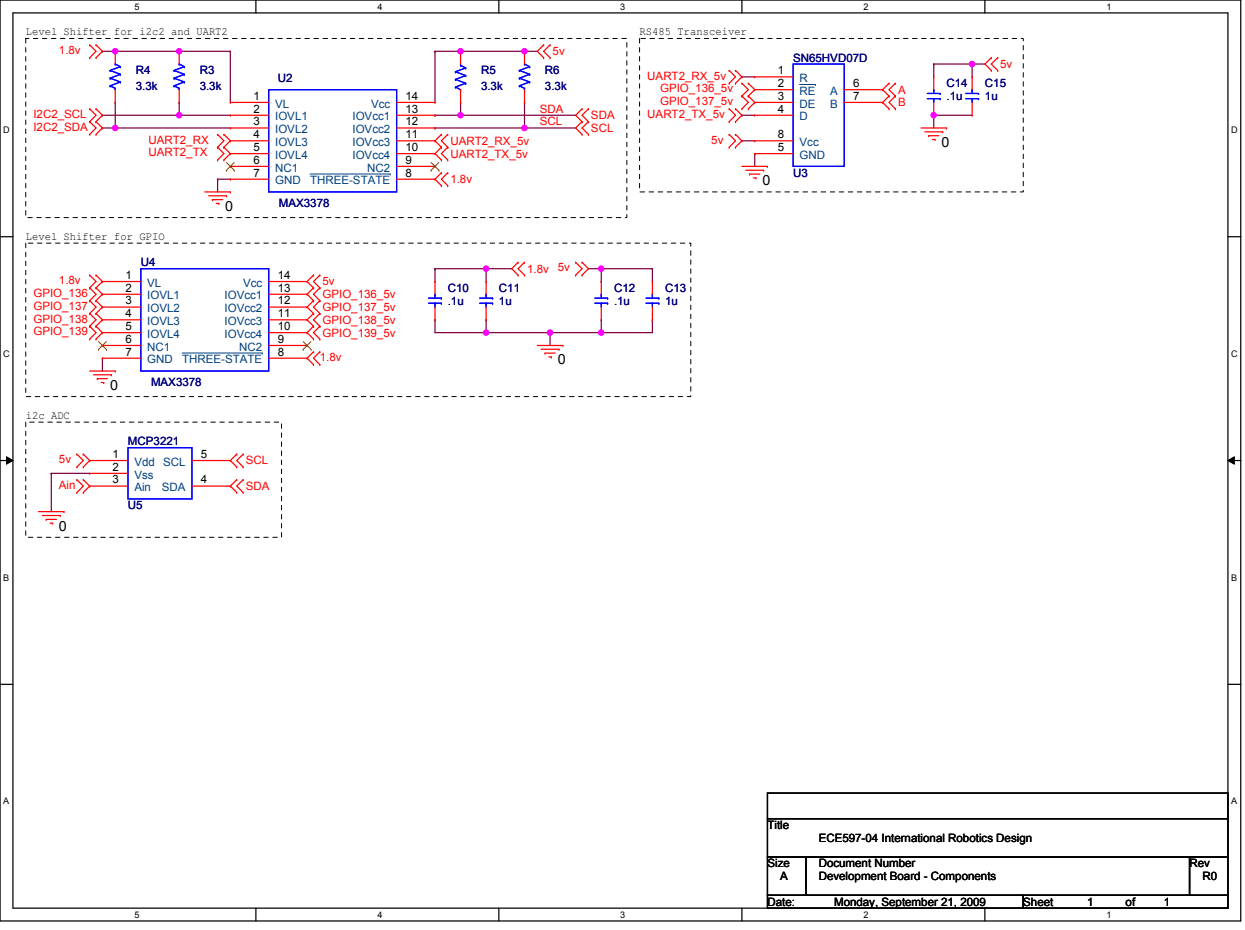
[picture p36: page 4]

Level Shifter for GPIO
