zetasyanthis/quadruped/(list of files, drawings)

Other design files:
ECE597_Robot_v2/quadruplex/trunk/pcb/DEV.DSN
ECE597_Robot_v2/quadruplex/trunk/pcb/DEV.OLB
ECE597_Robot_v2/quadruplex/trunk/pcb/Dev.opj
ECE597_Robot_v2/quadruplex/trunk/pcb/SN65HVD07D.olb
ECE597_Robot_v2/quadruplex/trunk/pcb/TLC548CD.OLB
ECE597_Robot_v2/quadruplex/trunk/pcb/TPS5420D.OLB
ECE597_Robot_v2/quadruplex/trunk/pcb/TPS5430DDA.OLB
