zetasyanthis/quadruped/ECE597_Robot_v2/quadruplex/branches/SNUT/v3 Motion Generator/turn.c

static char turnRight1[24][4]={
{100,0,0x34,0x2},
{0,1,0x58,0x1},
{0,2,0xB1,0x1},
{0,3,0xCC,0x1},
{0,4,0x7F,0x2},
{0,5,0x3,0x2},
{0,6,0x34,0x2},
{0,7,0x81,0x1},
{0,8,0xFD,0x1},
{0,9,0xCC,0x1},
{0,10,0xA8,0x2},
{0,11,0x4F,0x2},
{0,0,0x4F,0x2},
{0,1,0x9,0x1},
{0,2,0xCD,0x1},
{0,3,0xF0,0x1},
{0,4,0xA5,0x2},
{0,5,0x53,0x1},
{0,6,0x64,0x2},
{0,7,0x24,0x1},
{0,8,0x2E,0x2},
{0,9,0xD4,0x1},
{0,10,0x1C,0x3},
{0,11,0x6A,0x1}};

//turn right 15
moveMotor(0,581);
moveMotor(1,232);
moveMotor(2,580);
moveMotor(3,443);
moveMotor(4,721);
moveMotor(5,382);
moveMotor(6,581);
moveMotor(7,303);
moveMotor(8,642);
moveMotor(9,443);
moveMotor(10,792);
moveMotor(11,444);
wait_ms(1000);

moveMotor(0,591);
moveMotor(1,265);
moveMotor(2,461);
moveMotor(3,496);
moveMotor(4,677);
moveMotor(5,339);
moveMotor(6,612);
moveMotor(7,292);
moveMotor(8,558);
moveMotor(9,468);
moveMotor(10,796);
moveMotor(11,362);
wait_ms(1000);

//turn left 15
moveMotor(3,581);
moveMotor(4,232);
moveMotor(5,580);
moveMotor(6,443);
moveMotor(7,721);
moveMotor(8,382);
moveMotor(9,581);
moveMotor(10,303);
moveMotor(11,642);
moveMotor(12,443);
moveMotor(13,792);
moveMotor(14,444);
wait_ms(1000);

moveMotor(3,592);
moveMotor(4,265);
moveMotor(5,460);
moveMotor(6,496);
moveMotor(7,677);
moveMotor(8,339);
moveMotor(9,612);
moveMotor(10,292);
moveMotor(11,558);
moveMotor(12,468);
moveMotor(13,796);
moveMotor(14,362);
wait_ms(1000);

static char flail[24][4]={
{100,3,0x45,0x2},
{0,4,0xE8,0x0},
{0,5,0x44,0x2},
{0,6,0xBB,0x1},
{0,7,0xD1,0x2},
{0,8,0x7E,0x1},
{0,9,0x45,0x2},
{0,10,0x2F,0x1},
{0,11,0x82,0x2},
{0,12,0xBB,0x1},
{0,13,0x18,0x3},
{0,14,0xBC,0x1},
{0,3,0x50,0x2},
{0,4,0x9,0x1},
{0,5,0xCC,0x1},
{0,6,0xF0,0x1},
{0,7,0xA5,0x2},
{0,8,0x53,0x1},
{0,9,0x64,0x2},
{0,10,0x24,0x1},
{0,11,0x2E,0x2},
{0,12,0xD4,0x1},
{0,13,0x1C,0x3},
{0,14,0x6A,0x1}};
