zetasyanthis/quadruped/ECE597_Robot_v2/quadruplex/trunk/src/sumo/omap3530-pwm.c

// omap3530-pwm -- Control PWM outputs on the TI BeagleBoard C3 or C4
// Copyright (c) 2010 Thomas W. Most <tomwm@freecog.net>
//
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
#include <glib.h>
#include <unistd.h>
#include <stdio.h>
#include <fcntl.h>
#include <sys/types.h>
#include <sys/stat.h>
#include <sys/mman.h>
#include <errno.h>

#include "omap3530-pwm.h"

// Clock configuration registers (TRM p. 470)
#define CM_CLKSEL_CORE 0x48004A40
#define CLKSEL_GPT10_MASK (1 << 6)
#define CLKSEL_GPT11_MASK (1 << 7)

// GPTIMER register offsets
#define GPT_REG_TCLR 0x024
#define GPT_REG_TCRR 0x028
#define GPT_REG_TLDR 0x02c
#define GPT_REG_TMAR 0x038

// Get a guint32 pointer to the register in block `instance` at byte
// offset `offset`.
#define REG32_PTR(instance, offset) ((guint32*) (instance + offset))


// General purpose timer instances.  Not all of these can actually be
// used for PWM --- see the TRM for more information.
static guint32 gpt_instance_addrs[] = {
    0x48318000, // GPTIMER1
    0x49032000, // GPTIMER2
    0x49034000, // GPTIMER3
    0x49036000, // GPTIMER4
    0x49038000, // GPTIMER5
    0x4903a000, // GPTIMER6
    0x4903c000, // GPTIMER7
    0x4903e000, // GPTIMER8
    0x49040000, // GPTIMER9
    0x48086000, // GPTIMER10
    0x48088000, // GPTIMER11
    0x48034000, // GPTIMER12
};


// The default Linux page size is 4k and the GP timer register
// blocks are aligned to 4k.  Therefore it is convenient to just
// assume that pages are aligned there for the purposes of mmap()
// (since mmap only maps aligned pages).  This function checks
// that assumption and aborts if it is untrue.
static void
check_pagesize(void)
{
    if (getpagesize() != 4096) {
        g_error("The page size is %d.  Must be 4096.", getpagesize());
    }
}

// Simply a wrapper around mmap that passes the correct arguments
// for mapping a register block.  `instance_number` must be between
// 1 and 12, or errno will be set to EDOM and MAP_FAILED returned.
// Otherwise the return value is that of `mmap()`.
guint8*
pwm_mmap_instance(int mem_fd, int instance_number)
{
    if (instance_number < 1 || instance_number > 12) {
        errno = EDOM;
        return MAP_FAILED;
    }
    int instance_addr = gpt_instance_addrs[instance_number - 1];
    return mmap(NULL, 4096, PROT_READ | PROT_WRITE, MAP_SHARED, mem_fd, instance_addr);
}

// The inverse of `pwm_mmap_instance()`, this is simply a wrapper
// arount `munmap()`.  It returns the underlying `munmap()` call's
// return value.
int
pwm_munmap_instance(guint8 *instance)
{
    return munmap(instance, 4096);
}

// Configure the clocks for GPTIMER10 and GPTIMER11, which can be set to
// use the 13 MHz system clock (otherwise they use the 32 kHz clock like
// the rest of the timers).  Return -1 on failure, with errno set.
int
pwm_config_clock(int mem_fd, gboolean gptimer10_13mhz, gboolean gptimer11_13mhz)
{
    int page_addr = CM_CLKSEL_CORE & 0xfffff000;
    int offset = CM_CLKSEL_CORE & 0xfff;

    guint8 *registers = mmap(NULL, 4096, PROT_READ | PROT_WRITE, MAP_SHARED, mem_fd, page_addr);
    if (registers == MAP_FAILED) {
        return -1;
    }

    guint32 value = *REG32_PTR(registers, offset);
    value &= ~(CLKSEL_GPT10_MASK | CLKSEL_GPT11_MASK);
    if (gptimer10_13mhz) value |= CLKSEL_GPT10_MASK;
    if (gptimer11_13mhz) value |= CLKSEL_GPT11_MASK;
    *REG32_PTR(registers, offset) = value;

    return munmap(registers, 4096);
}

// Calculate the resolution of the PWM (the number of clock ticks
// in the period), which is passed to `pwm_config_timer()`.
guint32
pwm_calc_resolution(int pwm_frequency, int clock_frequency)
{
    float pwm_period = 1.0 / pwm_frequency;
    float clock_period = 1.0 / clock_frequency;
    return (guint32) (pwm_period / clock_period);
}

// Initialize the control registers of the specified timer
// instance for PWM at the specified resolution. 
void
pwm_config_timer(guint8 *instance, guint32 resolution, float duty_cycle)
{
    guint32 counter_start = 0xffffffff - resolution;
    guint32 dc = 0xffffffff - ((guint32) (resolution * (1.0 - duty_cycle)));

    // Edge condition: the duty cycle is set within two units of the overflow
    // value.  Loading the register with this value shouldn't be done (TRM 16.2.4.6).
    if (0xffffffff - dc <= 2) {
        dc = 0xffffffff - 2;
    }

    // Edge condition: TMAR will be set to within two units of the overflow 
    // value.  This means that the resolution is extremely low, which doesn't
    // really make sense, but whatever.
    if (0xffffffff - counter_start <= 2) {
        counter_start = 0xffffffff - 2;
    }

    *REG32_PTR(instance, GPT_REG_TCLR) = 0; // Turn off
    *REG32_PTR(instance, GPT_REG_TCRR) = counter_start;
    *REG32_PTR(instance, GPT_REG_TLDR) = counter_start;
    *REG32_PTR(instance, GPT_REG_TMAR) = dc;
    *REG32_PTR(instance, GPT_REG_TCLR) = (
        (1 << 0)  | // ST -- enable counter
        (1 << 1)  | // AR -- autoreload on overflow
        (1 << 6)  | // CE -- compare enabled
        (2 << 10) | // TRG -- overflow and match trigger
        (1 << 12)   // PT -- toggle PWM mode
    );
}

int
pwm_open_devmem(void)
{
    check_pagesize();

    return open("/dev/mem", O_RDWR | O_SYNC);
}

void
pwm_close_devmem(int dev_fd)
{
    /* This function is useful! */
    close(dev_fd);
}
