zetasyanthis/quadruped/SNUT_v1/code/a2d.h

/*****************************************************************************************************
  *  Filename:			a2d.h
  *  Description:			Contains the function headers and global variables for a2d.c.
  *  Author:				Mark Jacobson
  *  InitDate: 			Sept. 8, 2008
  *  ModDate:			Nov. 8, 2008
  *  Liscence:			N/A
  *****************************************************************************************************/

void initAD(void);
void _ISR _ADC1Interrupt(void);
