zetasyanthis/quadruped/SNUT_v1/code/includes.h

/*****************************************************************************************************
  *  Filename:			includes.h
  *  Description:			Contains the include files to be used with the project.  
  *  Author:				Adam Hoffman, Mark Jacobson
  *  InitDate: 			May. 5, 2008
  *  ModDate:			Nov. 8, 2008
  *  Liscence:			N/A
  *****************************************************************************************************/

#include <p33FJ256GP710.h>
#include <libpic30.h>
#include <stdlib.h>

#include "main.h"
#include "uart.h"
#include "i2c.h"
#include "a2d.h"
#include "timers.h"
#include "helper.h"
#include "path.h"
#include "ecanCommon.h"
#include "ecan1Config.h"
#include "ecan1Drv.h"
