zetasyanthis/quadruped/(notices)

Notices in the files:
ECE597_Robot_v2/quadruplex/trunk/src/sumo/omap3530-pwm.c:
under the terms of the GNU Lesser General Public License as published by the
Free Software Foundation; either version 2.1 of the License, or (at your
ECE597_Robot_v2/quadruplex/trunk/src/kernel/serial_core.c:
This program is free software; you can redistribute it and/or modify
it under the terms of the GNU General Public License as published by
the Free Software Foundation; either version 2 of the License, or
(at your option) any later version.
